ElvisAlive-Tone/LfoTaptempoBuddy/(list of files, drawings)

Other design files:
ExampleLedDriver.dch
LFOBuddy.dch
LFOBuddy.dip
