ElvisAlive-Tone/LfoTaptempoBuddy/(commit log)

2026-08-25 first push
    [LFOBuddy.dch]
2026-08-26 shape switch changed to on-off-on, code and docs polishing
2026-08-27 Random algorithm LED announcement better separated from tempo blinking
2026-08-27 Shape select flip while tapped improved so that tap is not used as other feature
    [main.c]
2026-08-27 minor docs and code fixes
    [main.c]
2026-09-02 Updated schematics , added PCB design
    [LFOBuddy.dch, LFOBuddy.dip]
2026-09-02 U2 regulator 7805 added to the module
    [LFOBuddy.dch, LFOBuddy.dip]
2026-09-03 patched ADC code and schematic update after testing
    [LFOBuddy.dch]
2026-09-05 Example LED driver, schematics and docs cleanup.
    [ExampleLedDriver.dch, LFOBuddy.dch]
